BenGuiMaJo/Exoskeleton-Glove/Documentation/Personal Report/JoniFELCE.md

SEMAINE 1 :

• Création du groupe 
-	CARBALLO Benjamin
-	VEBER Mathieu
-	FELCE Joni
-	MALEK Benjamin (quitté)

• Choix du projet 
Boule de billard interactive
Harpe Laser
→Main exosquelette

• Démarche
Réalisation de premier schéma sur brouillon 
Quel matériel ?
-	Une dizaine d’accéléromètres
-	Une dizaine de servo-moteurs (5 petits, 4 moyens, 1 imposant)
-	Gant (de motard)
-	Protection d’avant-bras
-	Matériél de récupération (aluminium, acier, étain)

• Les tâches :
-	Dislocation du bras en deux parties : main et avant bras
-	Construction de la main à l’imprimante 3D du FabLab (modélisation AutoDesk au préalable ?)
-	Agencement du circuit : où placer le différent matériel etc.. 
-	Choix de communication : Bluetooth ou WPAN ?
-	Code : → Calcul des angles accéléromètres, calibrage
      →Envoi des données, réception et traitement : action des servomoteurs
      →Modélisation 3D ? (facultatif)

SEMAINE 2 :

Recherche d’informations sur Internet : je suis tombé sur plusieurs vidéos intéressantes qui traitent du même projet que le notre. 
Il serait plus utile d’utiliser des bandes de résistance flexible plutôt que des accéléromètres. (conseil du professeur)

SEMAINE 3 :

Le professeur nous conseille d’utiliser des bandes de LED sur le gant, dont la couleur changera en fonction de l’inclination des doigts. Cela permettra de mettre en évidence la réception et le bon traitement des informations.
Liste de commande :
-	Gant fin et confortable (sous-gant)
-	Bandes de résistance flexible

SEMAINE 4 :

Vidéo-conférence pour création de la diapo de présentation du projet.
Comment allons-nous nous organiser ? →Diagramme de Gantt
On décide de se porter sur un module de communication WPAN avec une carte ZigBee.
Rajouter une carte LilyPad à notre liste de course qui est plus esthétique et moins encombrante.
On décide de bel et bien faire une modélisation 3D de notre gant !

MOIS DE FEVRIER :

Nous recevons nos commandes : résistances flexibles, servo-moteurs.
Nous simulons pendant la 1ère séance de ce mois un montage "clé" de ce projet qui est la rotation plus ou moins importante du servo-moteur en fonction de l'inclinaison de notre résistance fléxible. Nous réussissons la simulation sans trop de soucis. Il faudra biensur par la suite faire les différents calibrages nécessaires.
De mon côté, je récupère le gant que nous avons dégoté pour réaliser les coutures des résistances sur chaque doigt, bien aidé de ma mère pro-coutière. Le résultat est magnifique. Cependant, nous obtenons une main gauche..
Vidéo-conférences sur skype pour discuter à propos de la conception 3D de la main robotique, plan qui tombera finalement à l'eau.

SEMAINE 9/10 :

Pour améliorer l'esthétique du gant, nous prenons en main pendant la séance des bandes de LED fléxibles qui permettront d'interpréter plus facilement l'inclinaison des doigts. Nous décidons de commander ce type de LED car nous apprécions le rendu.

SEMAINE 11/12 :

Amélioration des coutures : le gant n'est pas pas assez serré, il faut le réajuster pour avoir des pliements de doigts plus précis!
Recherche d'une main en bois dans des magasins.
Vidéo-conférences Skype pour préparer la présentation orale de mi-parcours. Nous sommes en retard!
Commandes des différents composants : Lilypad (qu'on nous a volé), bandes LED, module Xbee (communication entre les deux mains).

SEMAINE 13/14 :

Recherche de plans d'une main 3D sur Internet format .stl que l'on pourra par la suite imprimer au FabLab. Nous trouvons des prototypes intéressants même si ces derniers n'accomplissent pas une rotation "complète" au niveau du pouce! Néanmoins, ces prototypes ont l'air d'assurer seuls le repliement des doigts, ce qui est une très bonne chose.
M.Masson nous "offre" gentillement ce qui nous servira pour l'élongation de notre avant-bras. Il nous faut commander un transformateur pour pouvoir l'utiliser.
Découverture pour Mathieu et moi du soudage, notre ami Benjamin ayant déjà manipulé. Nous réalisons de jolies soudures, même si le gant en aura quelques blessures de guerre.
Récupération du gant pour coudre les LED. Nous espérons finir le gant avant les vacances, pour cela, il nous faudrait retrouver notre Lilypad..

SEMAINE 15/16 : 

Couture des LED sur le gant. Réalisation des codes qui nous permettent de mettre en évidence la pliure des doigts.
Nous récupérons notre Lilypad.
Soudure des résistances et des fils sur notre gant.

SEMAINE 17/18/19 :

Plusieurs rendez-vous au FABLAB pour réaliser notre main robotique après avoir trouvé la main parfaite. Nous choisissons également une matière bien fléxible qui permettra la remise en place des doigts en leur position d'origine. Malheureusement, après 2 semaines de délais, nous récupérons notre main qui est mal réalisée, inutilisable. L'impression s'est mal déroulée à cause du matériau trop fléxible.

SEMAINE 20/21 :

Je commence à m'occuper du rapport du projet.
Recherche de comment fonctionne le module ZigBee et écriture de codes.
