BenGuiMaJo/Exoskeleton-Glove/Documentation/Slide/Exoskeleton Glove Fini.pdf

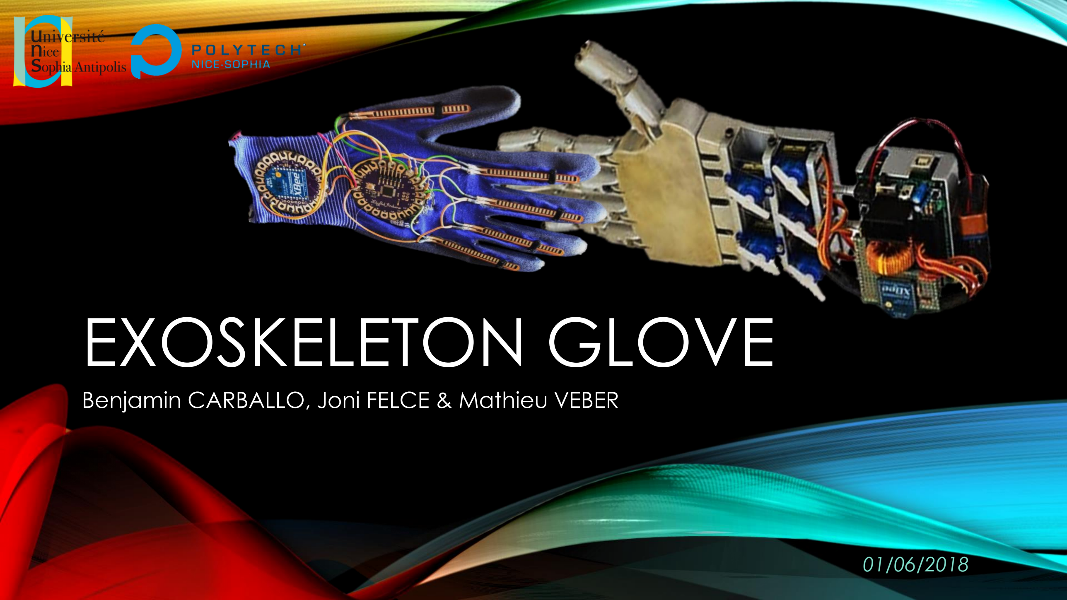
[picture p14: page 1]

# EXOSKELETON GLOVE

### Benjamin CARBALLO, Joni FELCE & Mathieu VEBER

01/06/2018

# SOMMAIRE

# I. Un Projet Ambitieux

# II. Nos Déboires

# III. Le Résultat Final

# I. UN PROJET AMBITIEUX

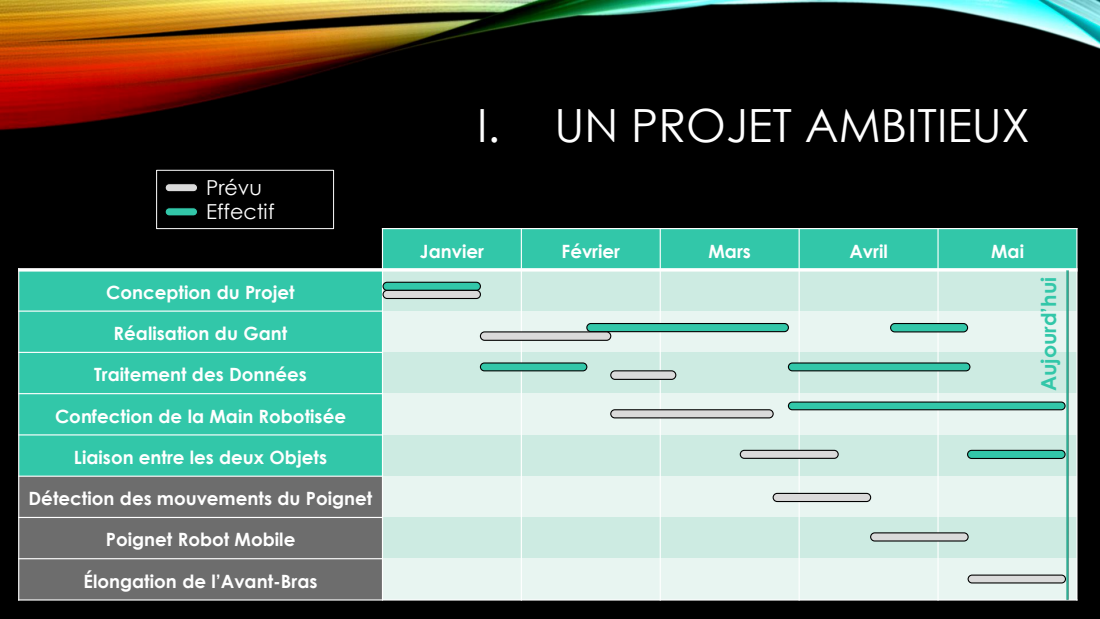
[picture p15: page 3]
Aujourd’hui; Prévu Effectif

Janvier | Février | Mars | Avril | Mai

Conception du Projet

Réalisation du Gant

Traitement des Données

Confection de la Main Robotisée

Liaison entre les deux Objets

Détection des mouvements du Poignet

Poignet Robot Mobile

Élongation de l’Avant-Bras

# II. NOS DÉBOIRES

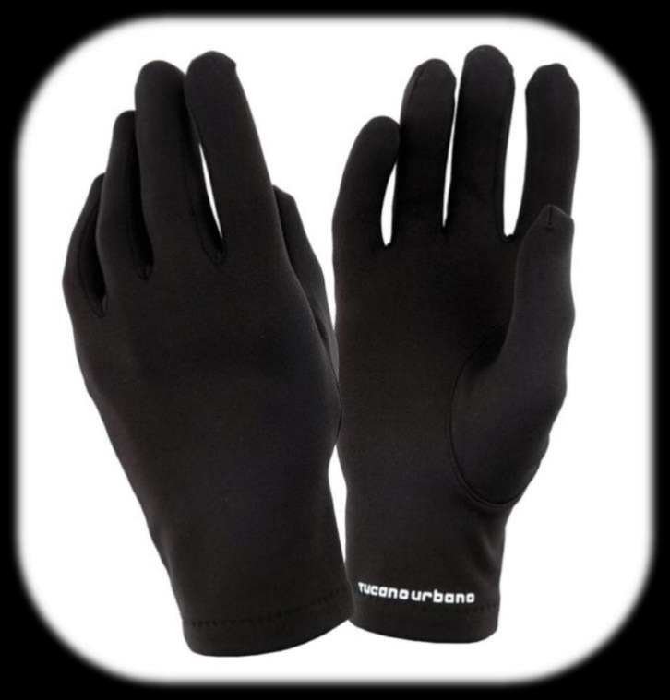
[picture p16: figure]

# - Gant connecté

Comment calibrer des + résistances qui fluctuent ? +

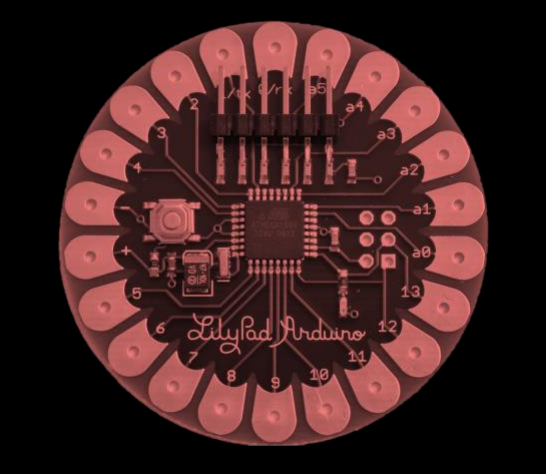
[picture p17: figure]

RIP Lilypad

# II. NOS DÉBOIRES

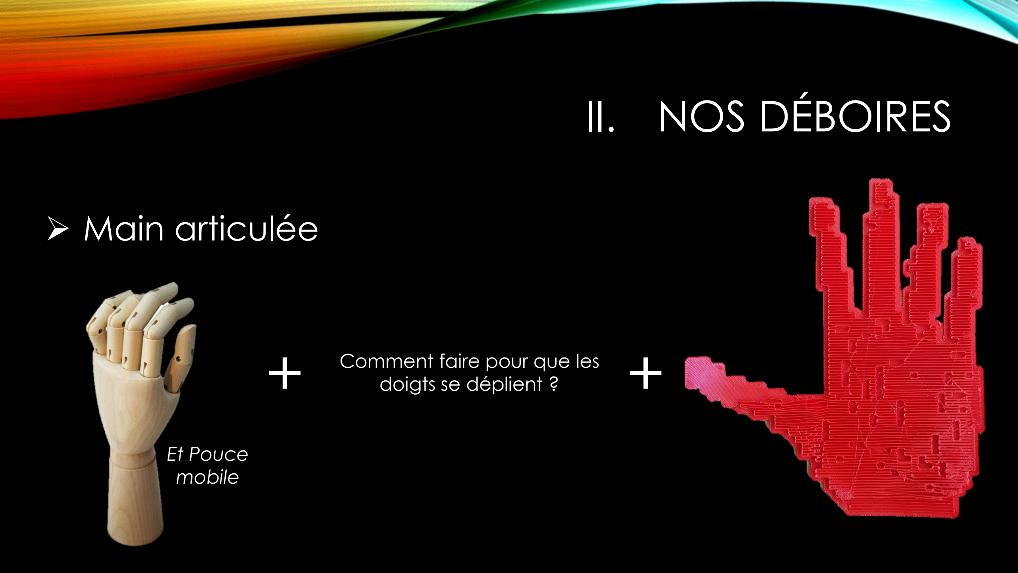
[picture p18: page 5]

# - Main articulée

Comment faire pour que les + | doigts se déplient ? | +

Et Pouce
mobile

# III. LE RÉSULTAT FINAL

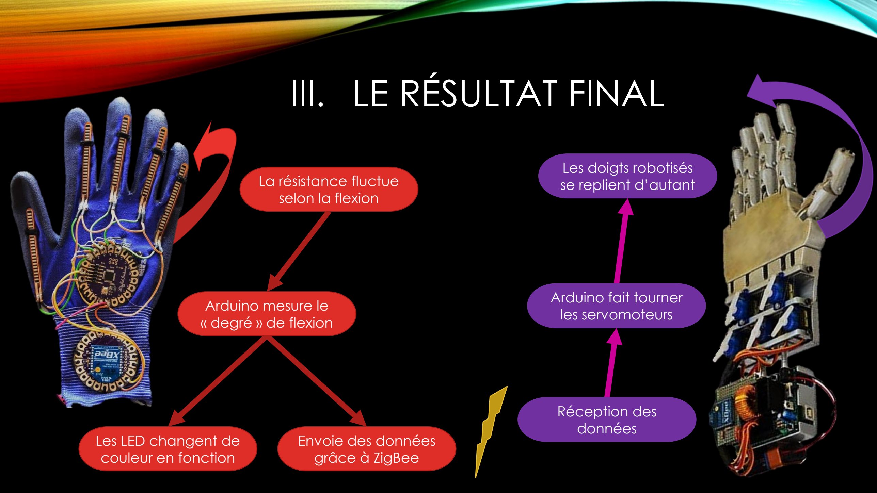
[picture p19: page 6]

Envoie des données
grâce à ZigBee

Les LED changent de
couleur en fonction

Arduino mesure le
« degré » de flexion

La résistance fluctue
selon la flexion

Les doigts robotisés
se replient d’autant

Arduino fait tourner
les servomoteurs

Réception des
données

# III. LE RÉSULTAT FINAL

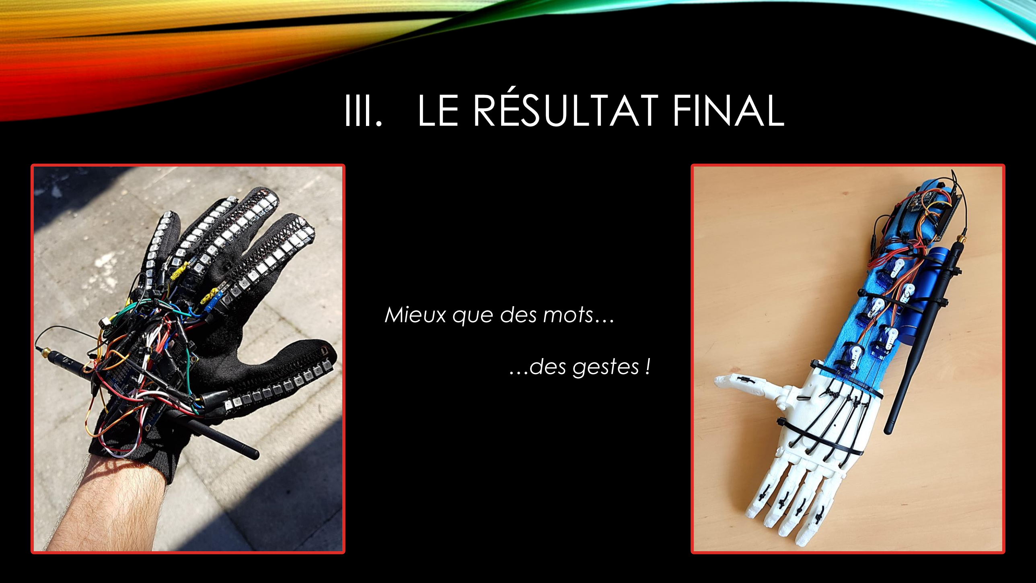
[picture p20: page 7]

Photo de nous avec le gant | Photo de nous avec la main

### Mieux que des mots…

### …des gestes !

# CONCLUSION ET PERSPECTIVES

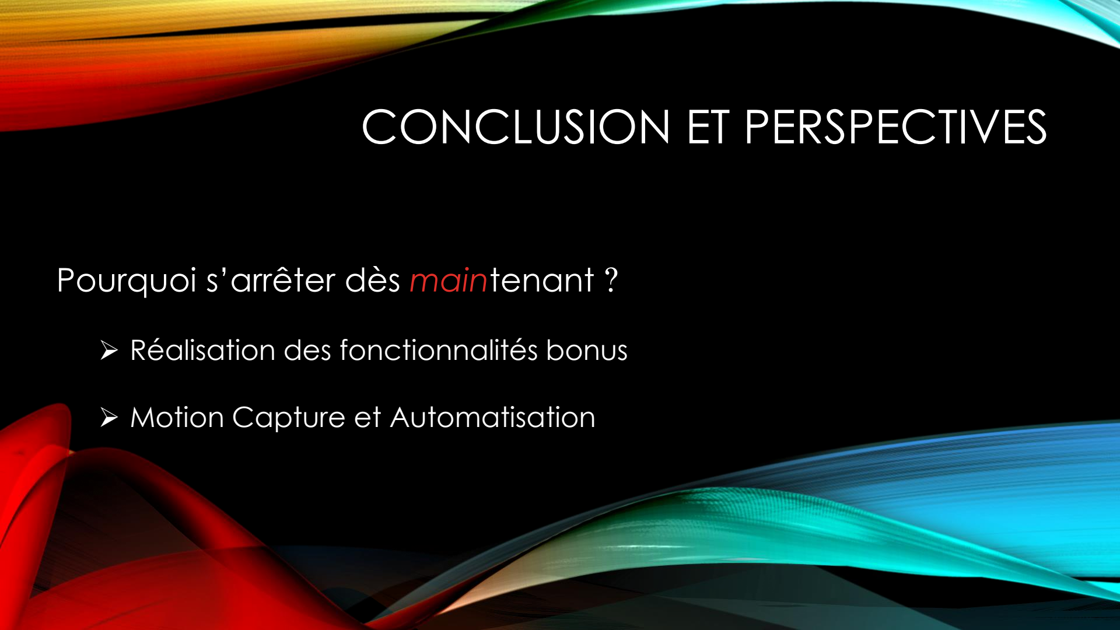
[picture p21: page 8]

# Pourquoi s’arrêter dès maintenant ?

## - Réalisation des fonctionnalités bonus

## - Motion Capture et Automatisation
