BenGuiMaJo/Exoskeleton-Glove/Documentation/Slide/Exoskeleton Glove.pdf

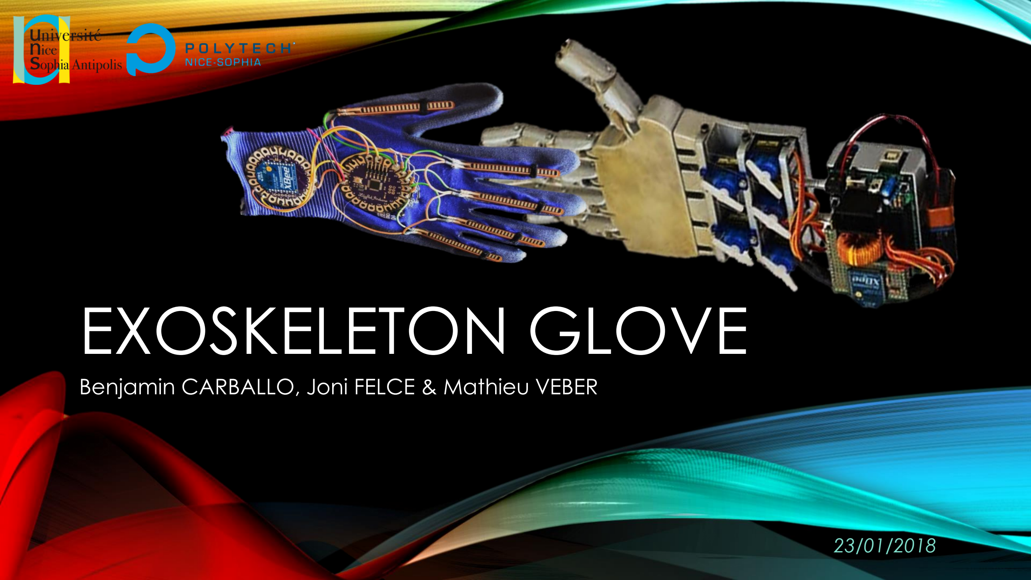
[picture p22: page 1]

# EXOSKELETON GLOVE

Benjamin CARBALLO, Joni FELCE & Mathieu VEBER

23/01/2018

## SOMMAIRE

I. Pourquoi Ce Choix ?

II. Nos Objectifs

III. La Conception Du Projet

IV. Notre Planning

## I. POURQUOI CE CHOIX ?

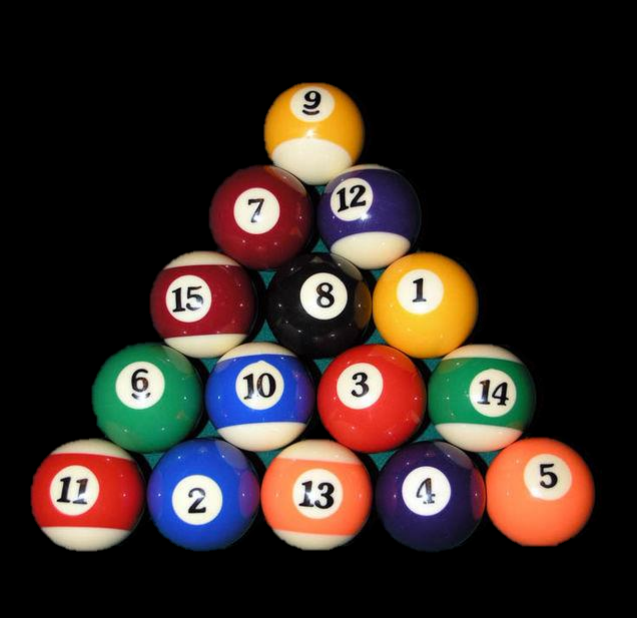
[picture p23: figure]
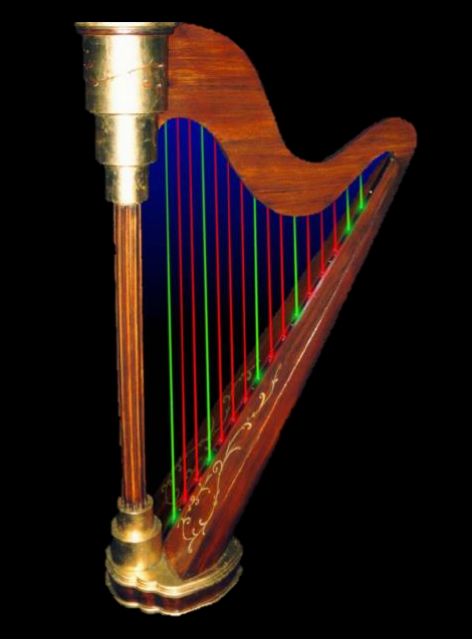
[picture p24: figure]

- Une boule de billard interactive

OU

- Une harpe laser

OU BIEN

- Une main robotisée contrôlée à distance

## I. POURQUOI CE CHOIX ?

➢Un Projet Complet…
Capteurs
Envoie de données
Réception et traitement de ces données Moteurs

➢…Aux applications Concrètes…
Militaires
Médicales

➢…Qui Relève Des Défis Contemporains
A terme robots humanoïdes
Exosquelettes

## II. NOS OBJECTIFS

➢Un gant capable d’interpréter les mouvements de nos doigts

➢Une main robotique reproduisant les mouvements avec un temps de latence inférieur à ½ seconde

Problématique :
Est-il possible d’associer la dextérité et la force d’un humain au sein d’une même main robotique de gabarit comparable ?

## III. CONCEPTION DU PROJET

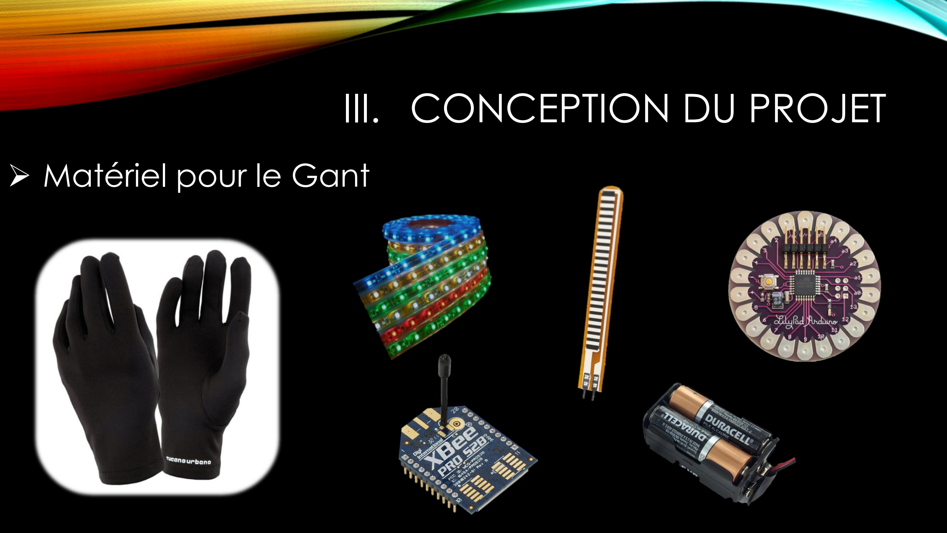
[picture p25: page 6]

## - Matériel pour le Gant

## III. CONCEPTION DU PROJET

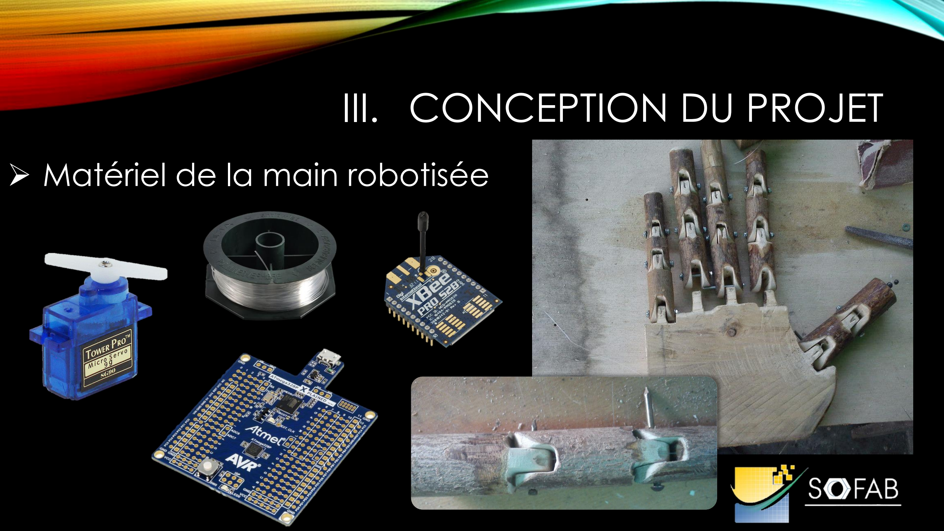
[picture p26: page 7]

## - Matériel de la main robotisée

## III. CONCEPTION DU PROJET

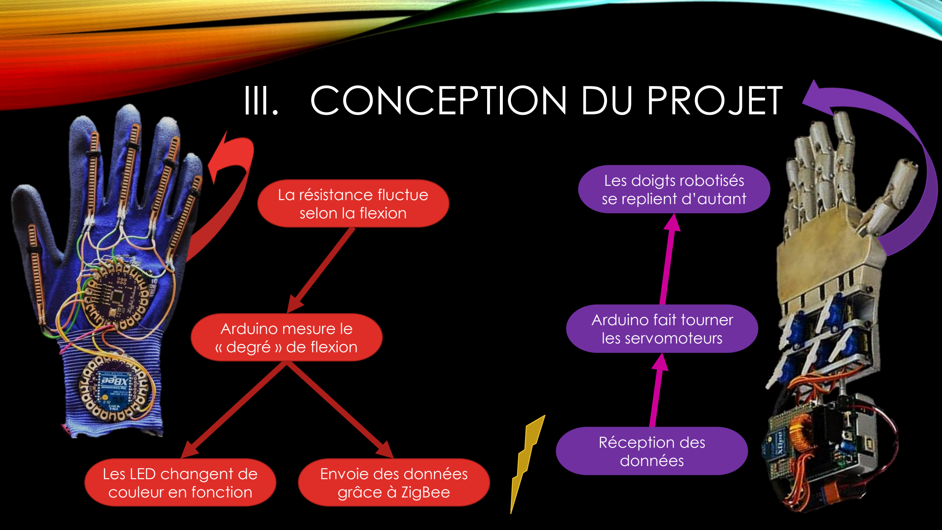
[picture p27: page 8]

Envoie des données
grâce à ZigBee

Les LED changent de
couleur en fonction

Arduino mesure le
« degré » de flexion

La résistance fluctue
selon la flexion

Les doigts robotisés
se replient d’autant

Arduino fait tourner
les servomoteurs

Réception des
données

## IV. PLANNING

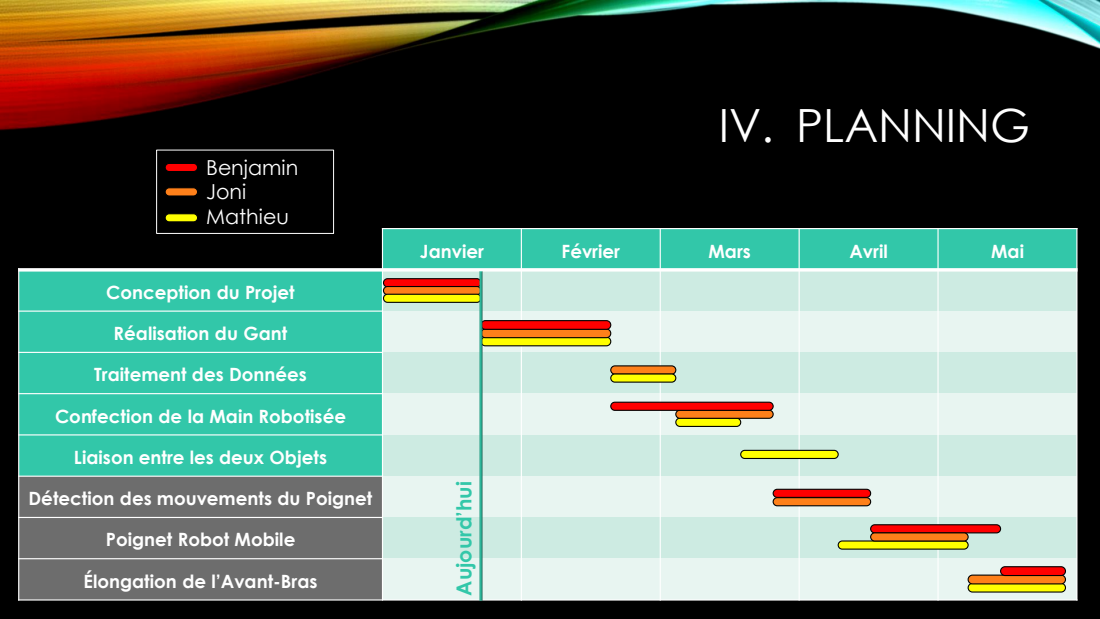
[picture p28: page 9]
Benjamin Joni Mathieu; Aujourd’hui

Janvier | Février | Mars | Avril | Mai

Conception du Projet

Réalisation du Gant

Traitement des Données

Confection de la Main Robotisée

Liaison entre les deux Objets

Détection des mouvements du Poignet

Poignet Robot Mobile

Élongation de l’Avant-Bras

## CONCLUSION ET PERSPECTIVES

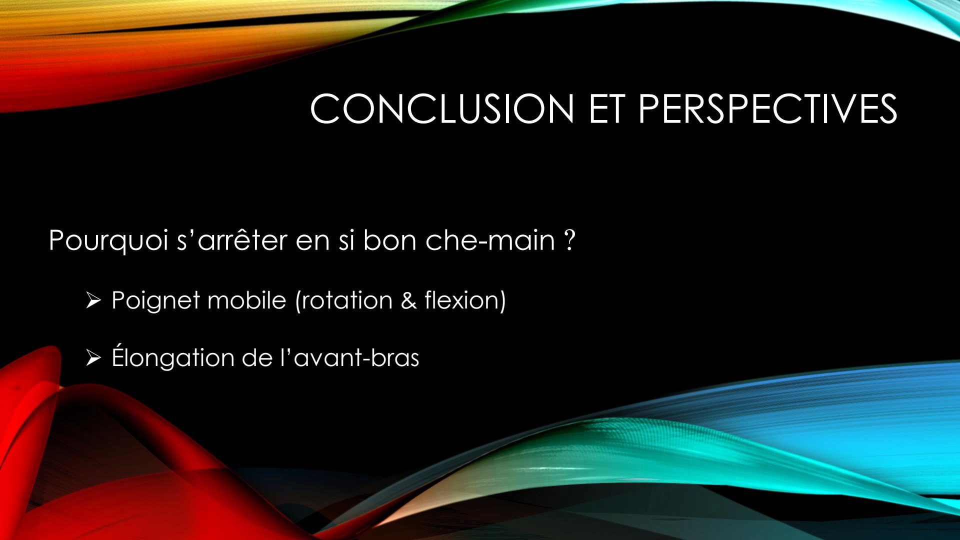
[picture p29: page 10]

Pourquoi s’arrêter en si bon che-main ?

- Poignet mobile (rotation & flexion)
- Élongation de l’avant-bras
