BenGuiMaJo/Exoskeleton-Glove/Documentation/Slide/Exoskeleton Glove Mi-Parcours.pdf

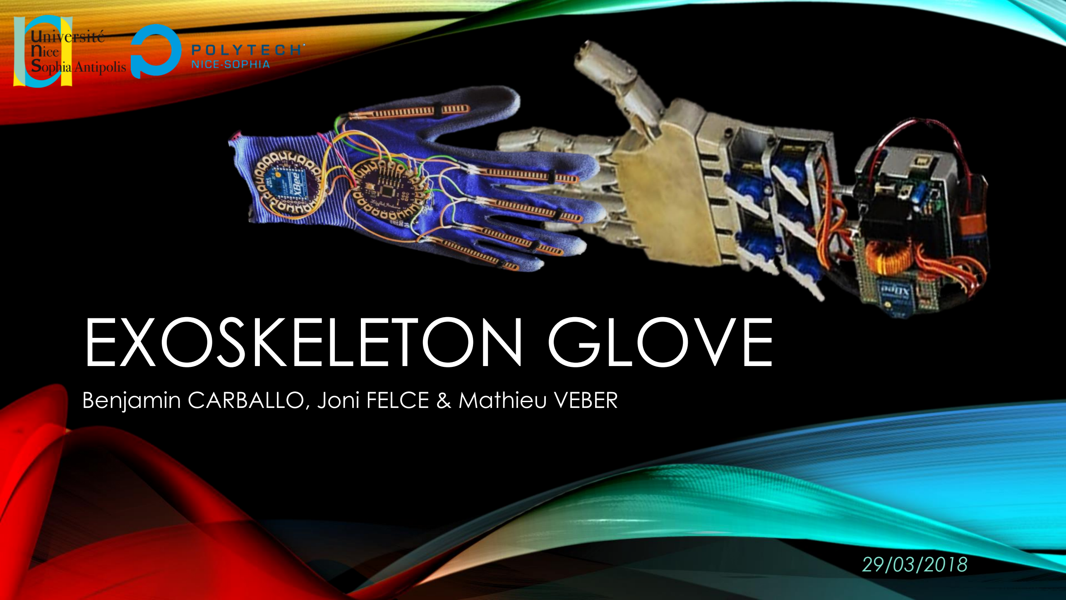
[picture p30: page 1]

# EXOSKELETON GLOVE

### Benjamin CARBALLO, Joni FELCE & Mathieu VEBER

29/03/2018

# I. PLANNING Aujourd’hui

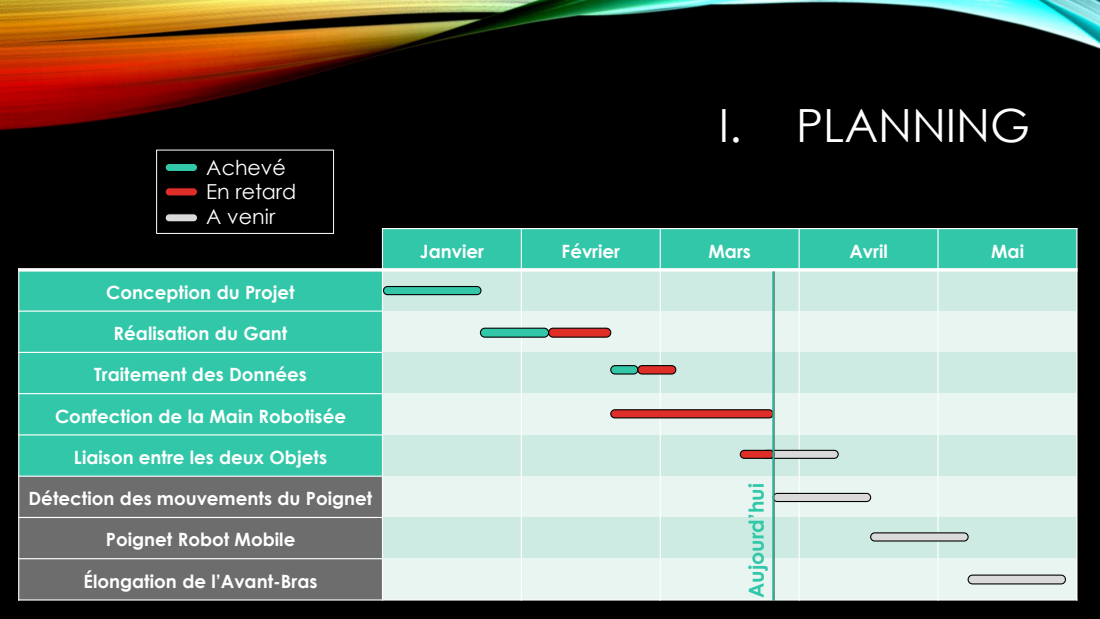
[picture p31: page 2]
Achevé En retard A venir

Janvier | Février | Mars | Avril | Mai

Conception du Projet

Réalisation du Gant

Traitement des Données

Confection de la Main Robotisée

Liaison entre les deux Objets

Détection des mouvements du Poignet

Poignet Robot Mobile

Élongation de l’Avant-Bras

# II. DIFFICULTÉS RENCONTRÉES

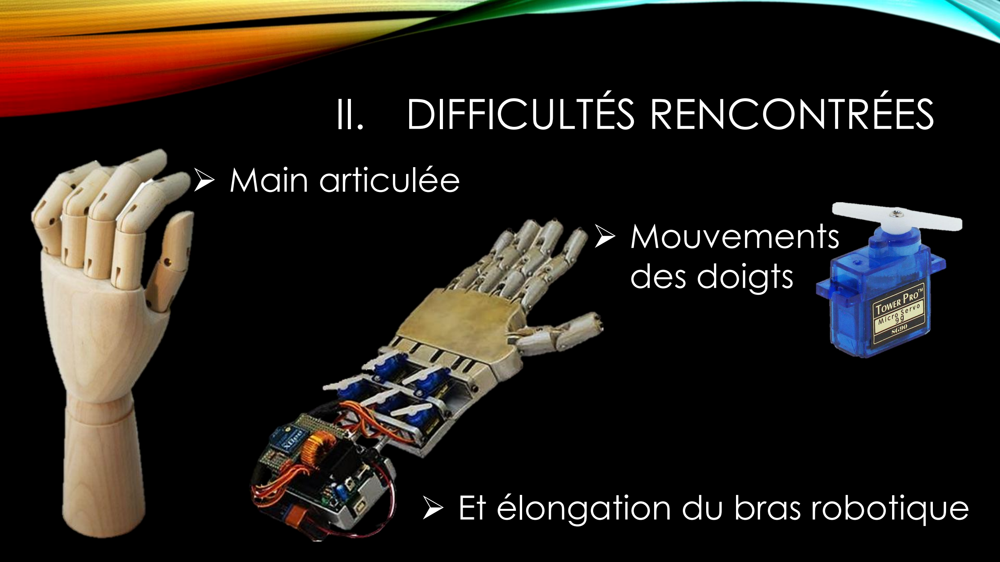
[picture p32: page 3]

# - Et élongation du bras robotique

# - Mouvements des doigts

# - Main articulée

# III. SOLUTIONS À PROPOSER

# - Main articulée

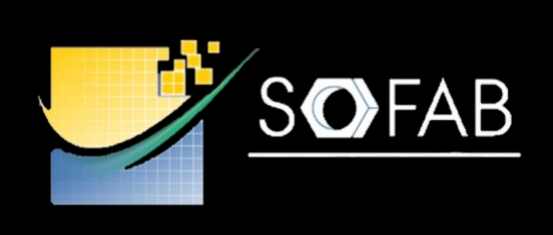
[picture p33: figure]

## Modèle adéquat avec pouce mobile

## OU Impression 3D

# III. SOLUTIONS À PROPOSER

# - Mouvements des doigts

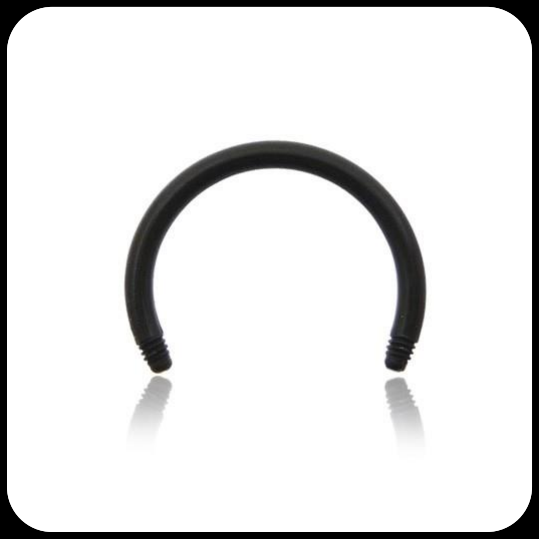
[picture p34: figure]
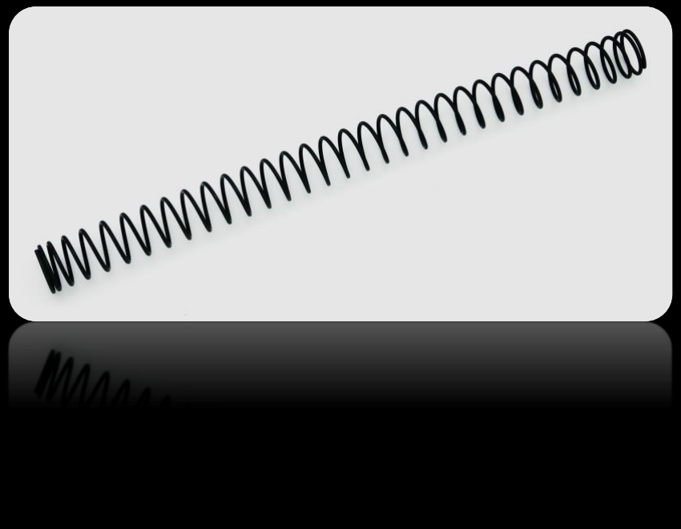
[picture p35: figure]
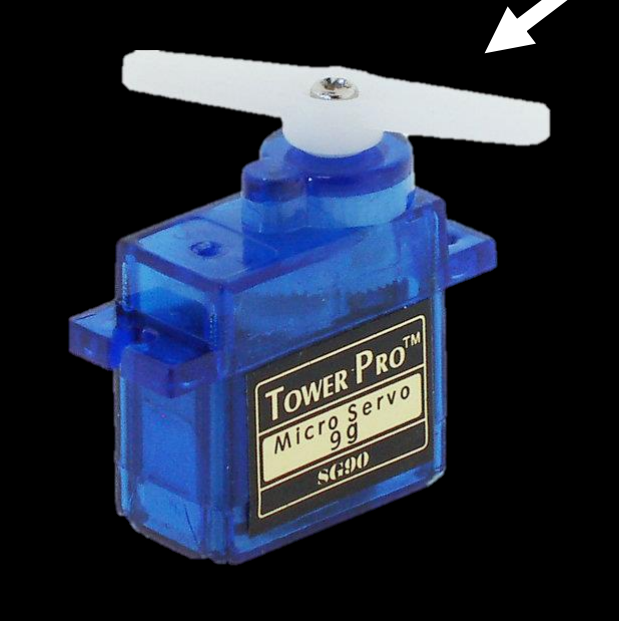
[picture p36: figure]

OU

# III. SOLUTIONS À PROPOSER

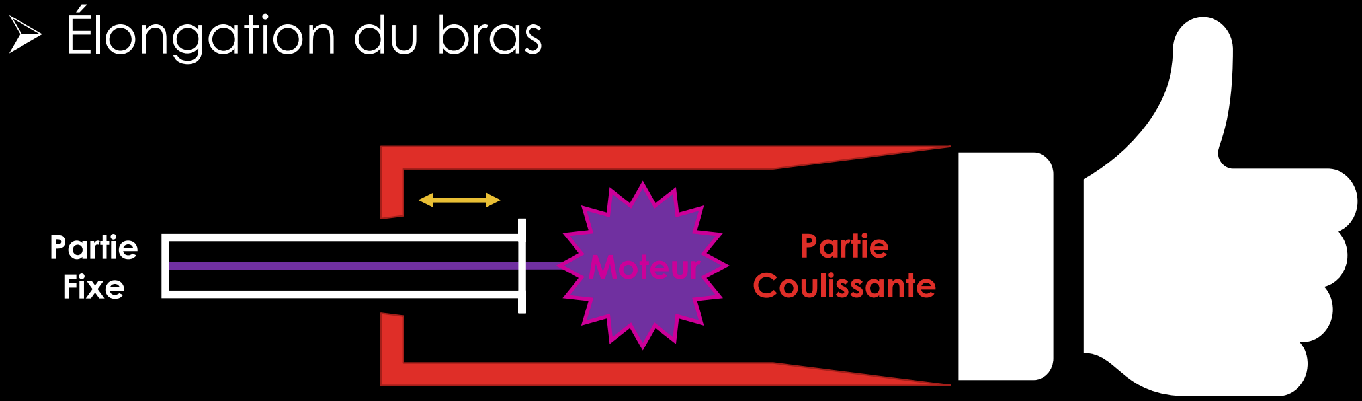
[picture p37: figure]
➢ Élongation du bras; Moteur; Partie; Coulissante; Partie Fixe

### Système coulissant contrôlé par un moteur denté

# CONCLUSION ET PERSPECTIVES

- D'ores et déjà… | ➢ Et très prochainement…

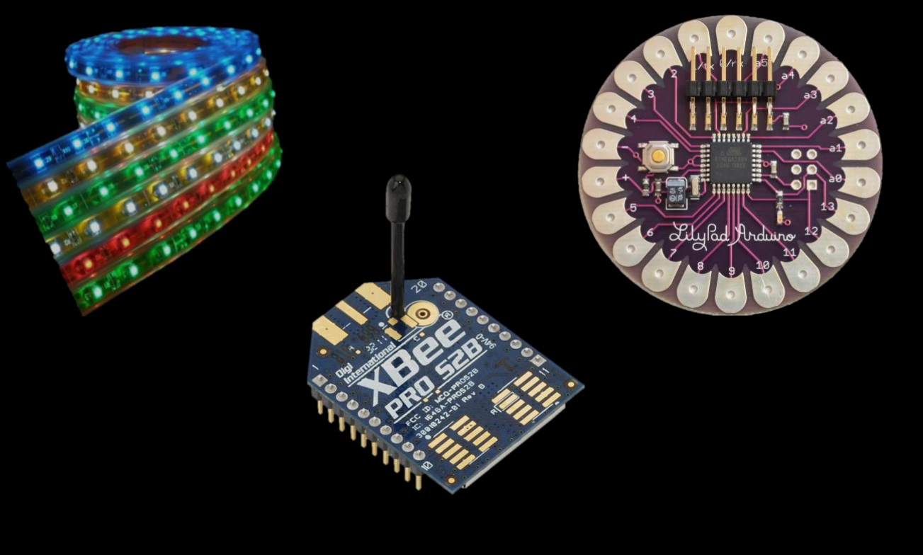
[picture p38: figure]

Constatez par vous-même,

### prototype à disposition
